wichr/Sofar2mqtt/stl/sofar2mqtt-no-tft.stl

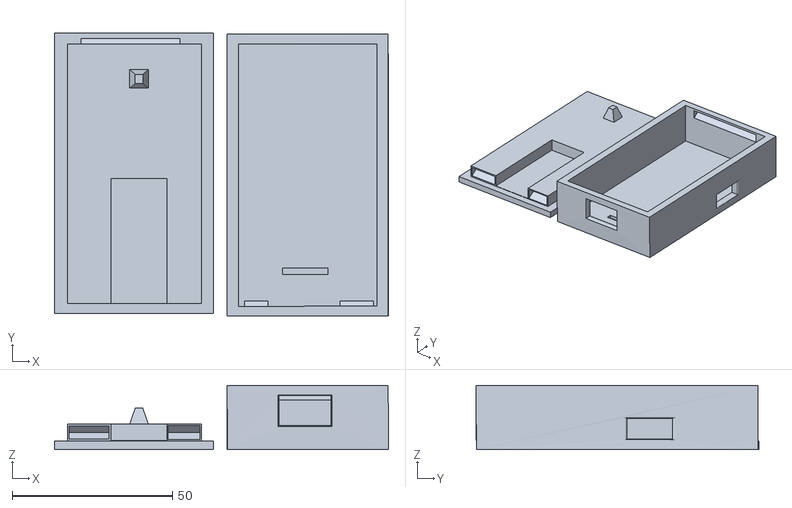
[picture p3: CAD file, 2023-04-03]
stl/sofar2mqtt-no-tft.stl
104.1 x 88.3 x 20.0
