wichr/Sofar2mqtt/stl/sofar2mqtt-tft.stl

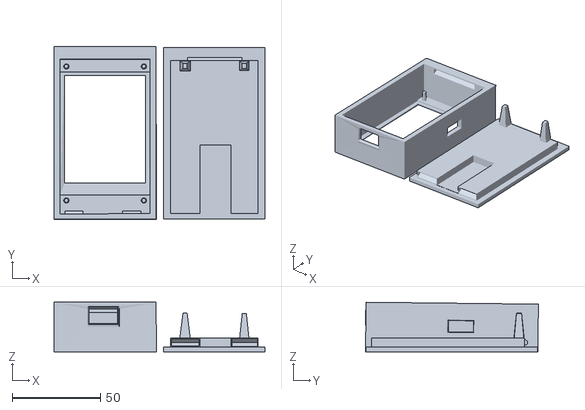
[picture p4: CAD file, 2023-04-03]
stl/sofar2mqtt-tft.stl
119.8 x 98.1 x 28.1
