wichr/Sofar2mqtt/(commit log)

2024-06-02 Update Sofar2mqtt.ino
    add information about voltage on all phases
2024-06-02 Update Sofar2mqtt.h
    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
2024-06-02 Update README.md
    add Full instructions to get going with a Sofar2mqtt, Raspberry Pi and Home Assistant.
2024-06-02 Update README.md
    Add link to Full instructions to get going with a Sofar2mqtt, Raspberry Pi and Home Assistant
2024-06-02 Add files via upload
    connecting rs485 cables to the sofar hyd 20 inverter
2024-06-02 Update README.md
    add connecting rs485 cables to the sofar hyd 20 inverter
